Sanitoll/Hugo-Anastasiia---Ethylobar/README.md

# Hugo-Anastasiia---Mini-bar
Mini bar contrôlé par un telephone. Pour l'utiliser, il faut réaliser un éthylotest et en fonction du résultat obtenu on pourra choisir une boisson.
