Sanitoll/Hugo-Anastasiia---Ethylobar/Rapports des séances/Séance 2/Hugo.md

Séance 2:
==

//Nous n'avons pas réussi à mettre les photos prises pendant la séance. Elles sont disponibles dans "Rapports des séances/Images"   //

Pour la séance 2 nous avons retravaillé la structure du bar; 

L'idée d'origine était de recréer un socle pour notre bar avec un tube central épais, pour qu'il puisse soutenir les bouteilles.
[IMG_4557.pdf](https://github.com/Sanitoll/Hugo-Anastasiia---Ethylobar/files/10367386/IMG_4557.pdf)

On nous a conseillé de reprendre la base du bar circulaire déja crée (le socle avec le tube au centre ainsi que les tiges tenant les bouteilles). 

Il nous faut maintenant découper l'engrenage en bois (où se tiendra le verre) et un plus grand support sur lequel on vissera le socle du bar déjà crée.

Ce plus grand support servira de socle au bar, et au moteur + engrenage faisant tourner la plateforme du verre.

Le tube central est actuellement en deux partie. La première soutenant les bouteilles, et le socle. La deuxieme partie tourne sur la première.
On doit empécher le mouvement entre les deux pièces pour avoir un tube immobile et fixé au socle; Pour ce faire, on a d'abord pensé à plaquer la première pièce à la seconde par le haut avec un boulon. Mais la solution retenue est d'utilise de la colle époxy.

On s'est ensuite rendu compte que le tube central n'etait pas assez haut et que donc nous aurions été obligés de prendre un petit verre.
On a donc decide de recréer un tube plus long; On a coupé deux tubes en PVC de diamètres differents. Le plus fin sera fixé à l'intérieur du tube épais. Cette méthode nous permet d'avoir un tube plus large, et donc de fixer 6 bouteilles au lieu de 4.

Afin de fixer les deux tubes ensemble, on a tout d'abord pensé à mettre de la colle entre les deux tubes, mais cette méthode ne garantissait pas que les deux tubes soient centrés.
La méthode que l'on va utiliser sera donc de créer deux anneaux avec la découpeuse laser. Ces anneaux ont un diamètre de 57mm ce qui correspond au diamètre interne du grand tube, et sont percés d'un cercle de 50mm de diamètre. Nous allons coller ces anneaux aux deux tubes pour garantir un centrage précis et solide des tubes.

La semaine prochaine Hugo viendra à la séance du lundi soir et Anastasiia celle habituelle du vendredi. Hugo va créer les anneaux et collera les tubes. 
Si roues folles à billes sont reçues, Hugo pourra créer les plans pour decouper les engrenages et le socle. Sinon il avancera sur le code Arduino de notre bar. Anastasiia a cours le vendredi, donc si l'engrenage et le socles sont decoupés, elle pourra assembler le bar. 
Si les roues ne sont pas arrivées, elle avancera sur le code Arduino et fera des tests avec les moteurs. 

Idéalement, d'ici la fin de la semaine prochaine il faudrait que notre bar soit assemblé ou au moins qu'on possède toutes les pièces du bar et qu'on se soit avancés sur le code.
