Sanitoll/Hugo-Anastasiia---Ethylobar/Rapports des séances/Séance1/Séance1 Hugo.md

Séance 1:
==

Pour la séance 1 nous avons travaillé ensemble;

En effet, nous avions besoin de mettre au clair et finaliser notre organisation avec l'aide de nos professeurs. On a donc décidé de faire passer l'ethylomètre au second plan, et se concentrer sur le bar qui est plus difficile à réaliser.

On a cherché les manières de servir l'alcool. On avait le choix entre des pompes qui sont plus simple a réaliser mais que l'on trouvait moins esthétique ou des doseurs, plus compliqué mais qui ressemblent plus à un vrai bar. Le problème avec les doseurs est qu'il faut trouver un moyen de les actionner pour faire couler l'alcool dans le verre. 
Nous avons donc observé deux exemples des années précédentes et avons décidé de faire un melange des deux: 
Notre bar sera circulaire avec les bouteilles au centre et un plateau roulant sera posé sur le socle du bar pour faire bouger le verre. Sur le socle on vissera nos bouteilles et leur doseur. 
Sur le plateau juste derrière le verre sera installé le dispositif qui actionnera les doseurs. 

Pour avoir une idée de l'ensemble nous avons représenté notre projet sur Oneshape (le liens avec les explications sont dans le dossier; <https://cad.onshape.com/documents/ad576a40a2abcba2ee003d8b/w/880adc32a25fd0e591d6406b/e/1fe776d56e54f4b2257ffb02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>).

Finalement, on a cherché d'autres exemples sur internet. On a trouve plusieurs sites dans lesquels il était indiqué le materiel nécessaire et quelques codes Arduino. Pour le materiel nous allons avoir besoin de : 
* Un module Bluetooth HM10 (pour Iphone)
* Un écran LCD ( on souhaite affdicher des messages sur notre bar)
* Des "roues a billes" pour notre plateau tournant 
* Un capteur MQ-3 pour notre éthylomètre
