Sanitoll/Hugo-Anastasiia---Ethylobar/Rapports des séances/Séance1/Schéma sur Onshape.md

https://cad.onshape.com/documents/ad576a40a2abcba2ee003d8b/w/880adc32a25fd0e591d6406b/e/1fe776d56e54f4b2257ffb02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

Voici le lien du schéma, il faut aller dans l'onglet Assembly1 afin de voir toutes les pièces de notre structure.

La grande roue dentée tourne autour des bouteilles, le verre est posé sur cette roue. 
La petite roue dentée est entrainée par un moteur.

Les bouteilles seront fixées en utilisant le même système que les projets de mini bar précédents (C'est a dire que le système sera vissé a deux trous que j'ai représenté.)

Sur ce schéma, le bar peut avoir 6 bouteilles.
