Sanitoll/Hugo-Anastasiia---Ethylobar/CahierDesCharges.md

Matériel electronique:
  -1capteur de vapeur d'alcool type capteur MQ-3
  -1 moteur pour déplacer le verre
  
Materiel de "construction":
  -
